bvanhoose14/Smart-Bike-Kit/README.md

# Project BITbike

### Group Members: **Spencer Durrant, Ben Van Hoose, Tristan Stotesbery**

Welcome to our senior project github repository. For information about it please see our [website.](https://bvanhoose14.github.io/Smart-Bike-Kit/)
