bvanhoose14/Smart-Bike-Kit/5780 Mini Project/5780 Project Proposal.pdf

5780 Project Proposal
Group Members: Spencer Durrant, Ben Van Hoose, Tristan Stotesbery

Our group’s project idea is to make an LED-Matrix “License Plate” That can be attached to bicycles or ebikes, that can be controlled by a phone via bluetooth to send messages such as turn signals, brake lights, or just general display messages. The LED Matrix will be attached to a microcontroller, which will have a bluetooth module that interfaces with a phone as well as handlebar mounted buttons that can send different images to the display.

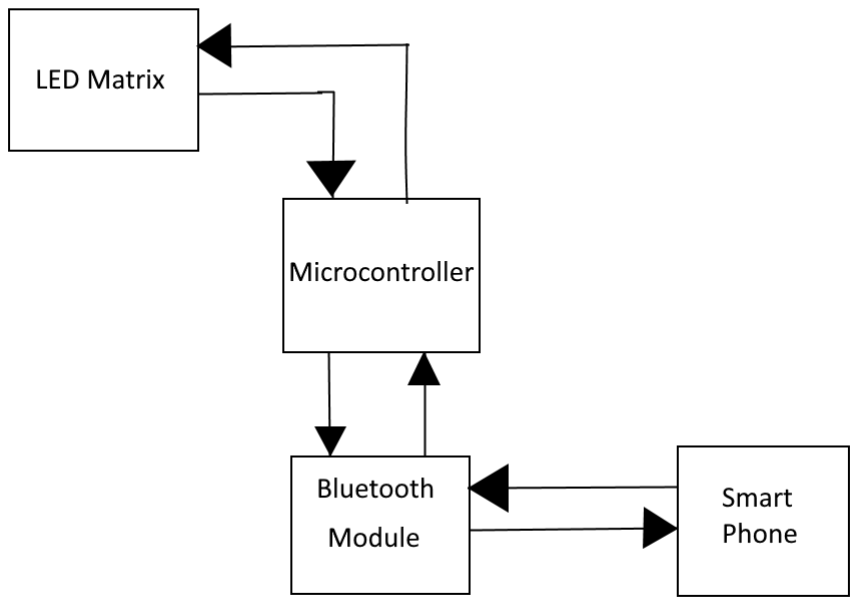
[picture p8: figure]

Milestone 1: Control microcontroller with phone via bluetooth module
Milestone 2: Connect and interface led matrix with microcontroller
Milestone 3: Power system with custom portable power supply
Milestone 4: Send images and signals to Microcontroller from phone to display on matrix
