bvanhoose14/Smart-Bike-Kit/Resources/BlockDiagram.pdf

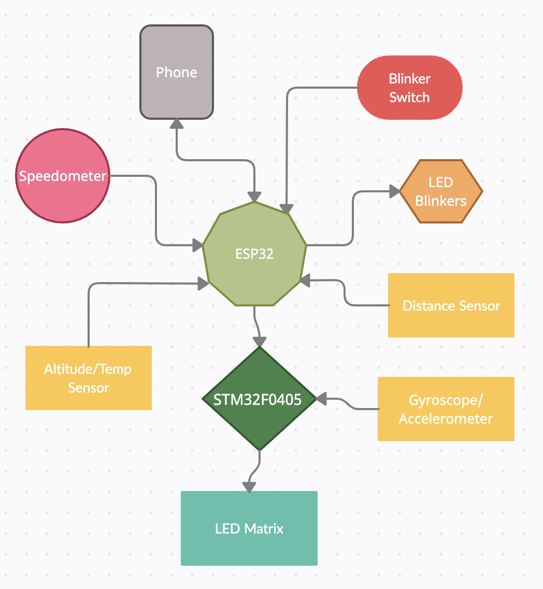
[picture p9: figure]
