bvanhoose14/Smart-Bike-Kit/images/ben.jpg

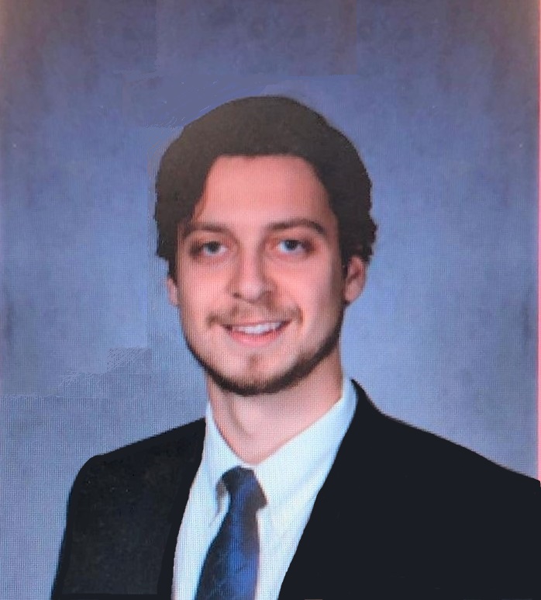
images/ben.jpg
