bvanhoose14/Smart-Bike-Kit/images/ebike.jpg

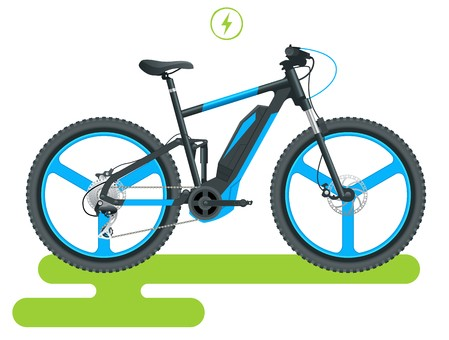
images/ebike.jpg
