bvanhoose14/Smart-Bike-Kit/images/exp32.jpg

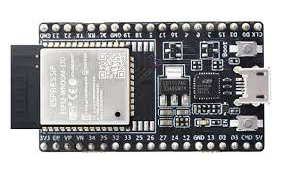
images/exp32.jpg
