bvanhoose14/Smart-Bike-Kit/images/mtbike2.jpg

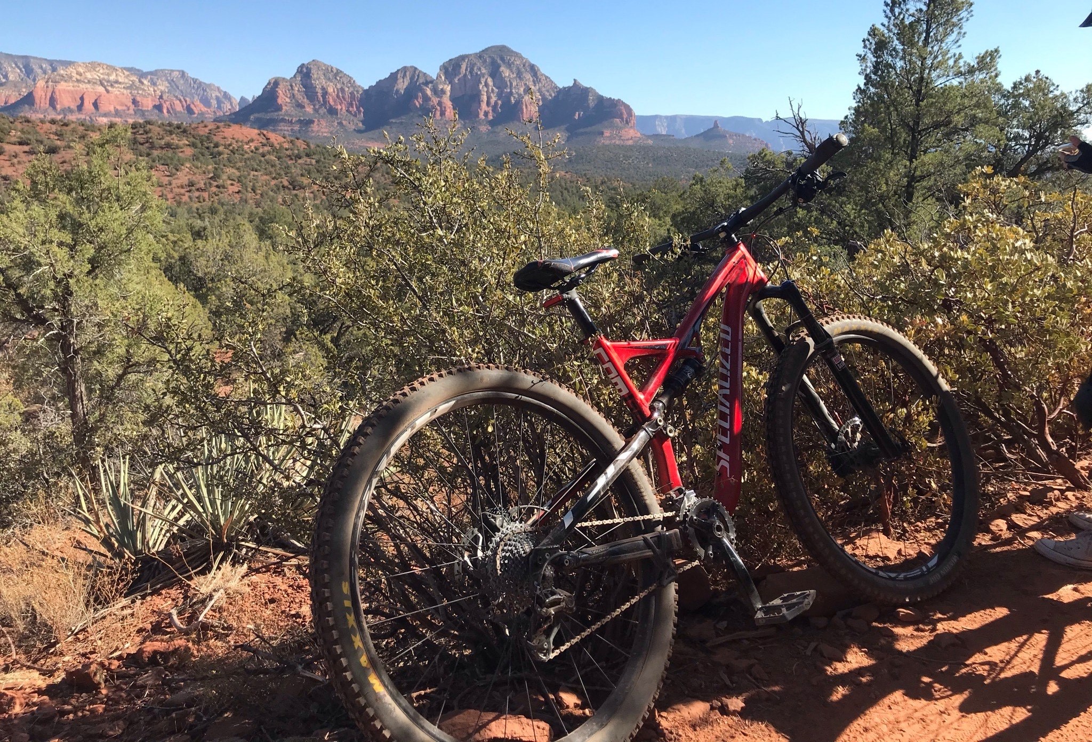
images/mtbike2.jpg
