bvanhoose14/Smart-Bike-Kit/images/rgbmatrix.jpg

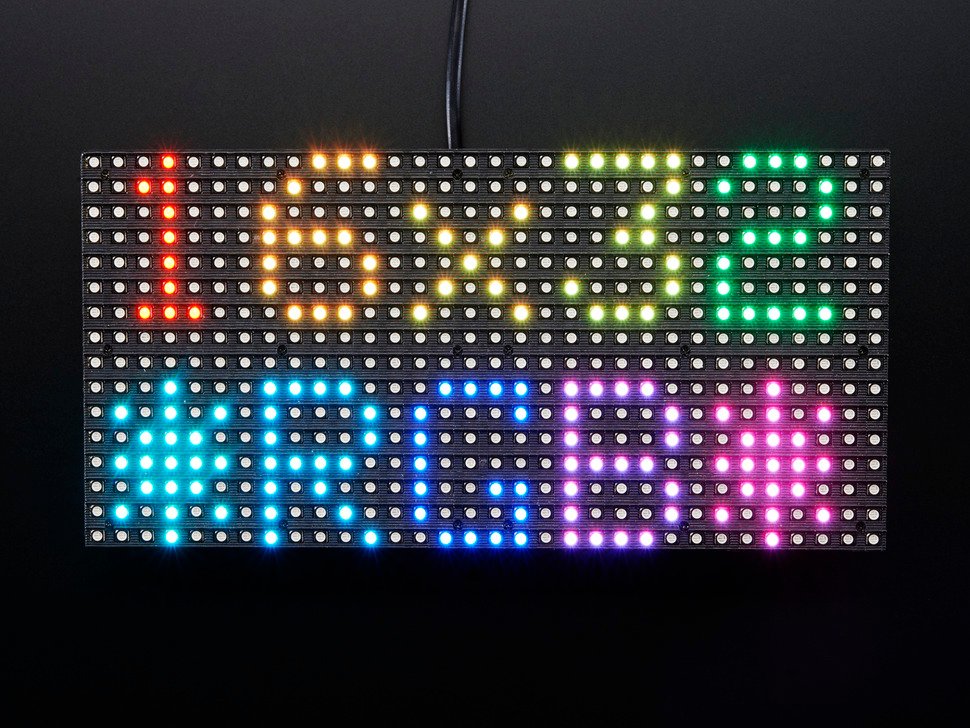
images/rgbmatrix.jpg
