bvanhoose14/Smart-Bike-Kit/images/slot-canyon-flash-flood2.jpg

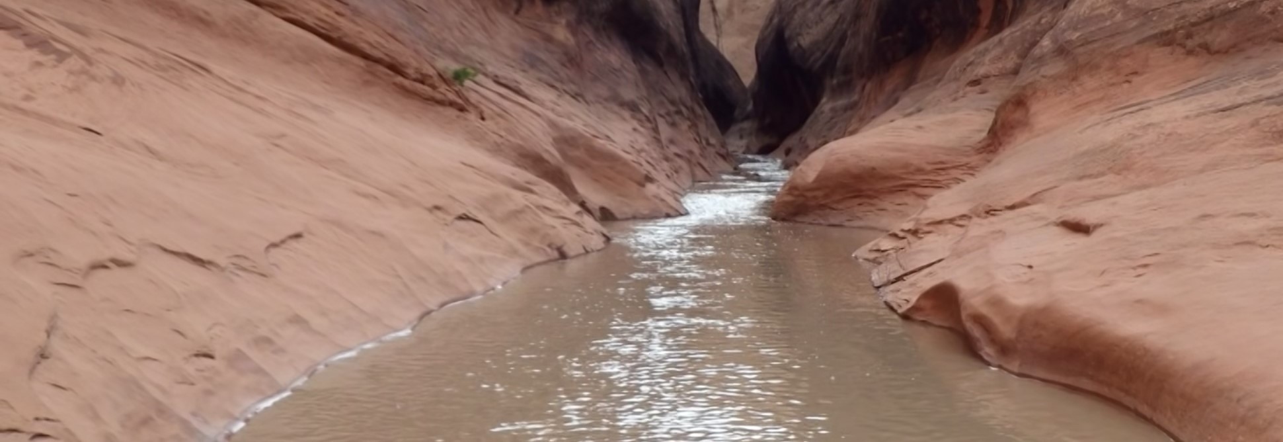
images/slot-canyon-flash-flood2.jpg
