bvanhoose14/Smart-Bike-Kit/images/slot-canyon-flash-flood.jpg

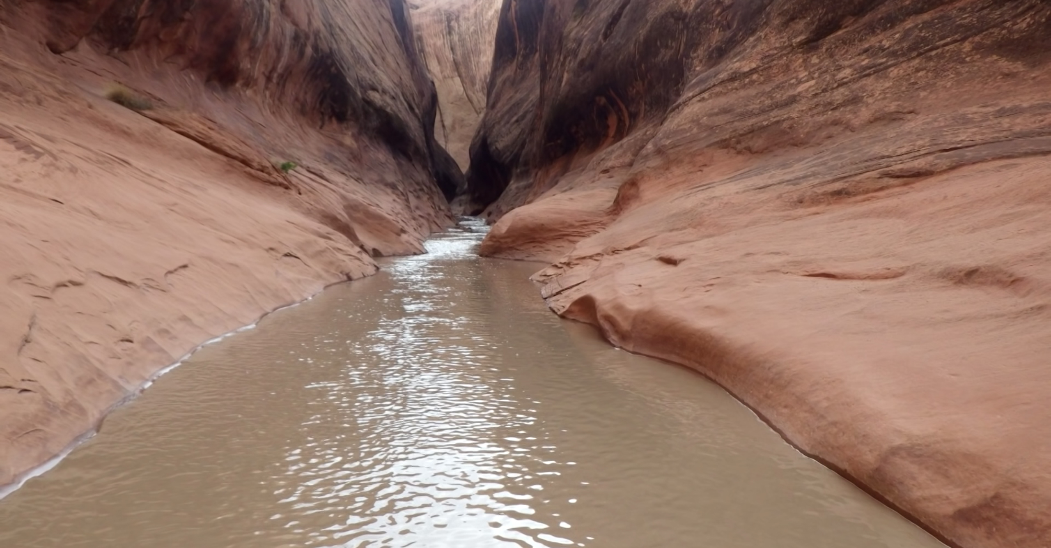
images/slot-canyon-flash-flood.jpg
