bvanhoose14/Smart-Bike-Kit/images/smbike_block_dgm.PNG

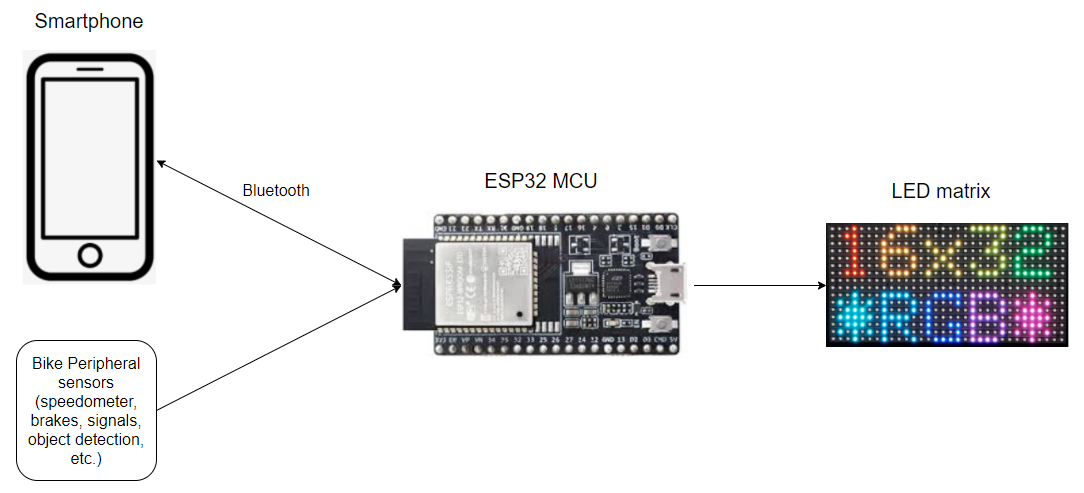
images/smbike_block_dgm.PNG
