bvanhoose14/Smart-Bike-Kit/images/spencer.jpg

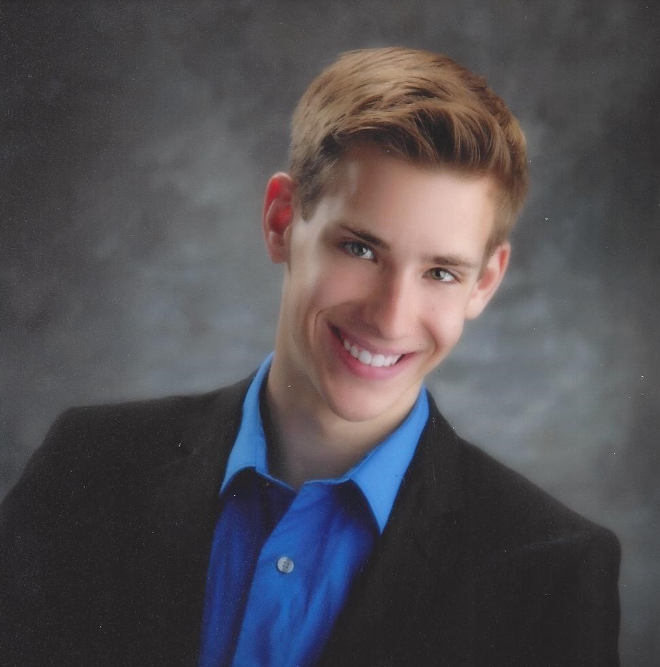
images/spencer.jpg
