bvanhoose14/Smart-Bike-Kit/images/tristan.JPG

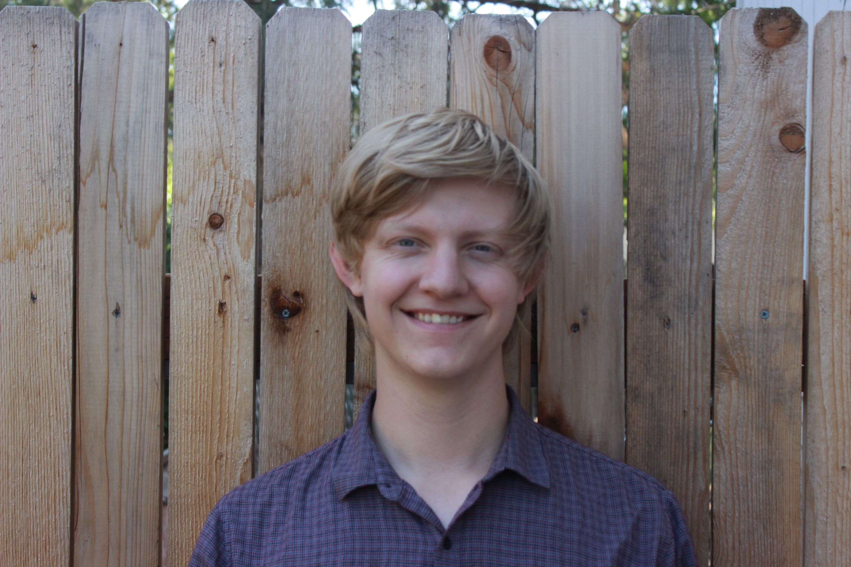
images/tristan.JPG
