bvanhoose14/Smart-Bike-Kit/images/water.jpg

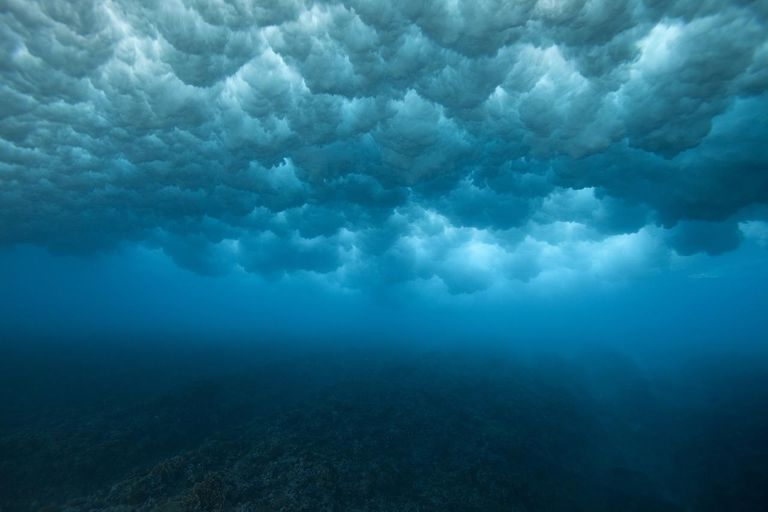
images/water.jpg
