bvanhoose14/Smart-Bike-Kit/3d-print/bitbike-print1.3mf

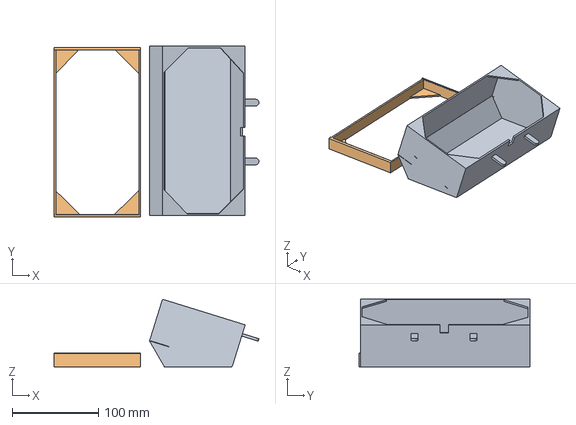
[picture p21: CAD file, 2021-11-15]
3d-print/bitbike-print1.3mf
237.1 x 198.2 x 78.2 mm
bitbike-print1 (3).stl
bitbike-print2.stl
