bvanhoose14/Smart-Bike-Kit/images/power-supply-diagram.pdf

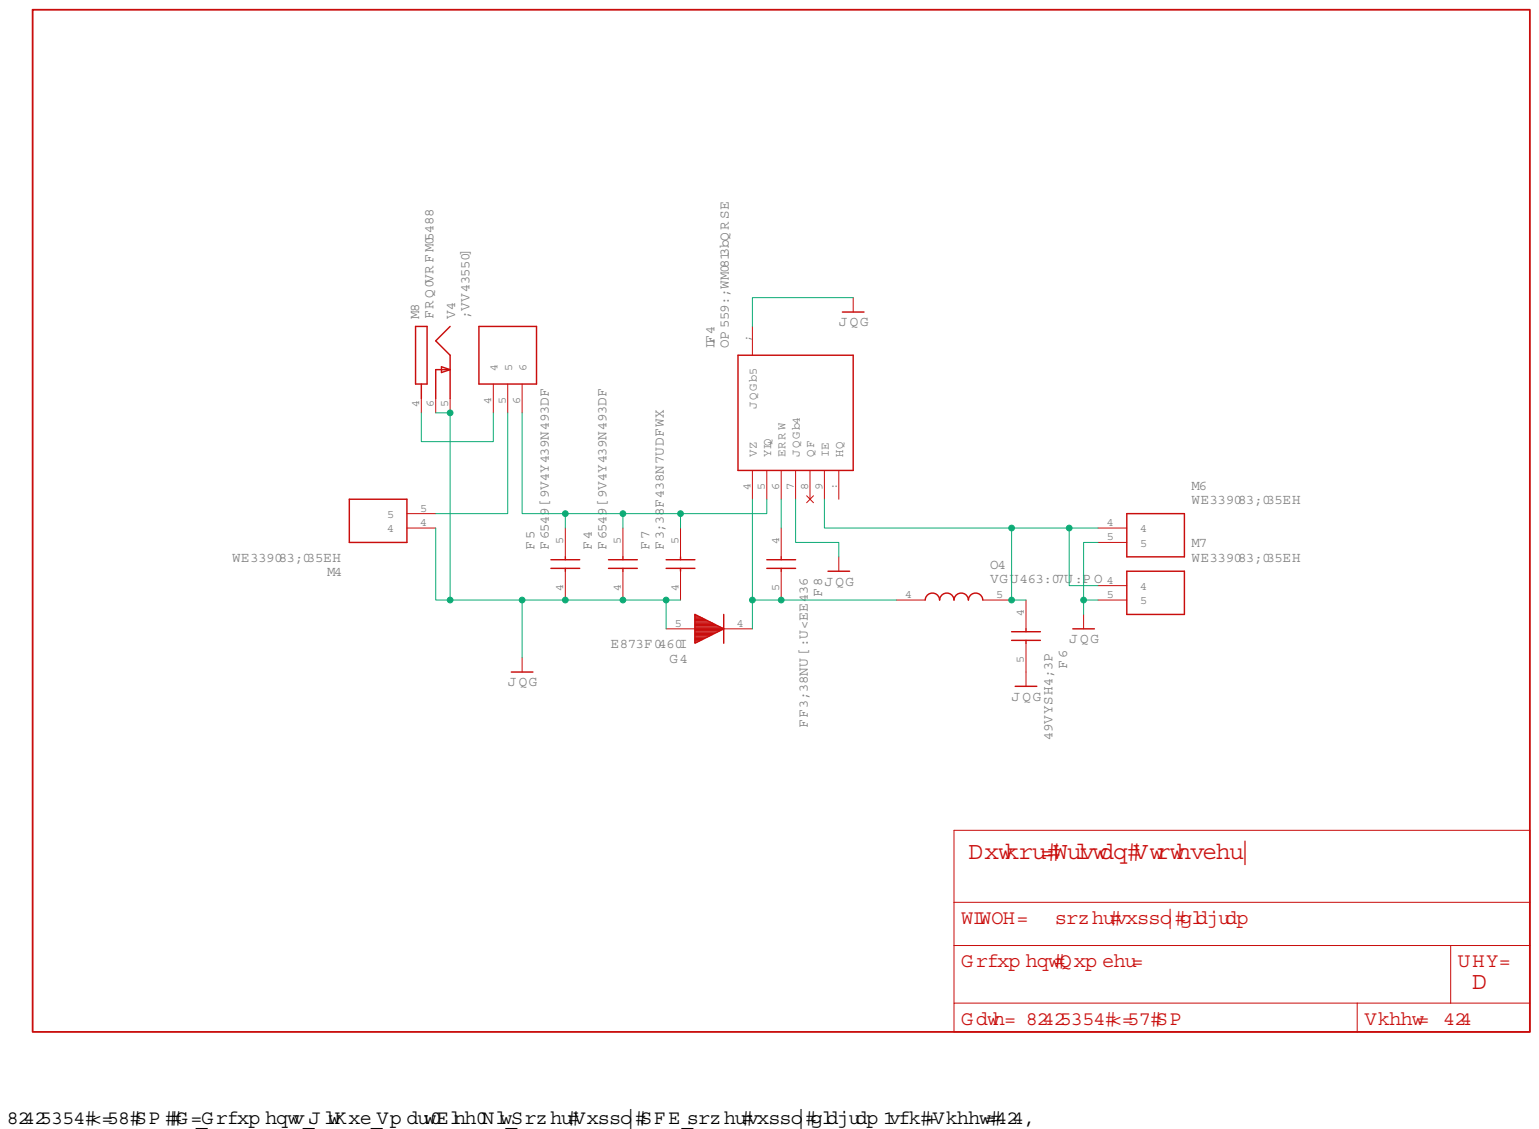
[picture p22: page 1]

pow er supply diagram

D ocum ent N um ber:

D ocum ents\GitH ub\Sm art-Bike-Kit\Pow er Supply PCB\pow er supply diagram .sch (Sheet: 1/1)
