bvanhoose14/Smart-Bike-Kit/5780 Mini Project/Power Supply PCB/power-supply-board.pdf

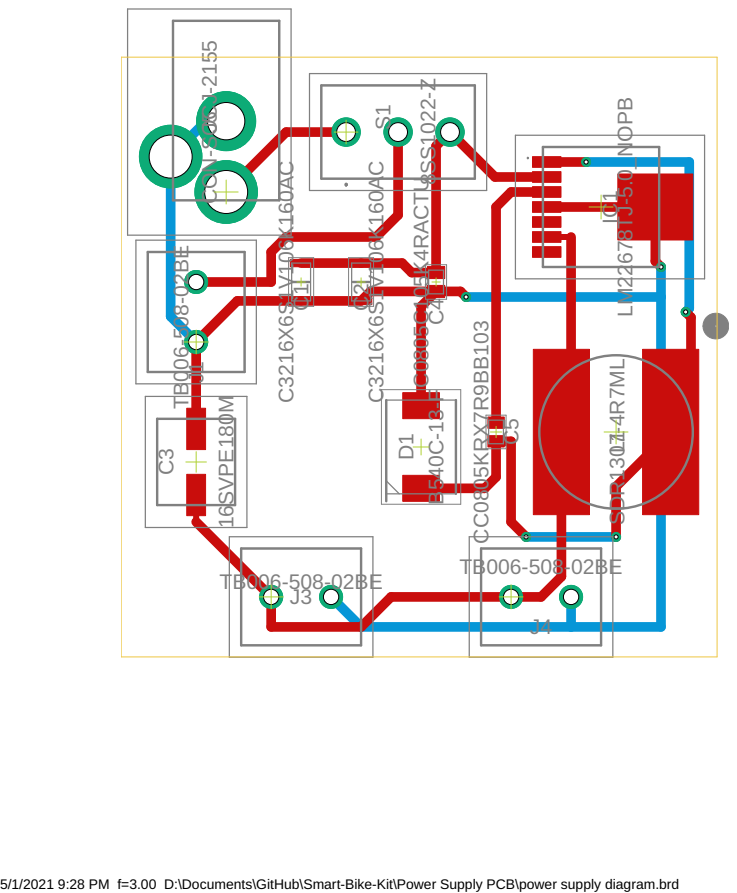
[picture p23: page 1]

5/1/2021 9:28 PM f=3.00 D:\Documents\GitHub\Smart-Bike-Kit\Power Supply PCB\power supply diagram.brd
