bvanhoose14/Smart-Bike-Kit/5780 Mini Project/Power Supply PCB/power-supply-diagram.pdf

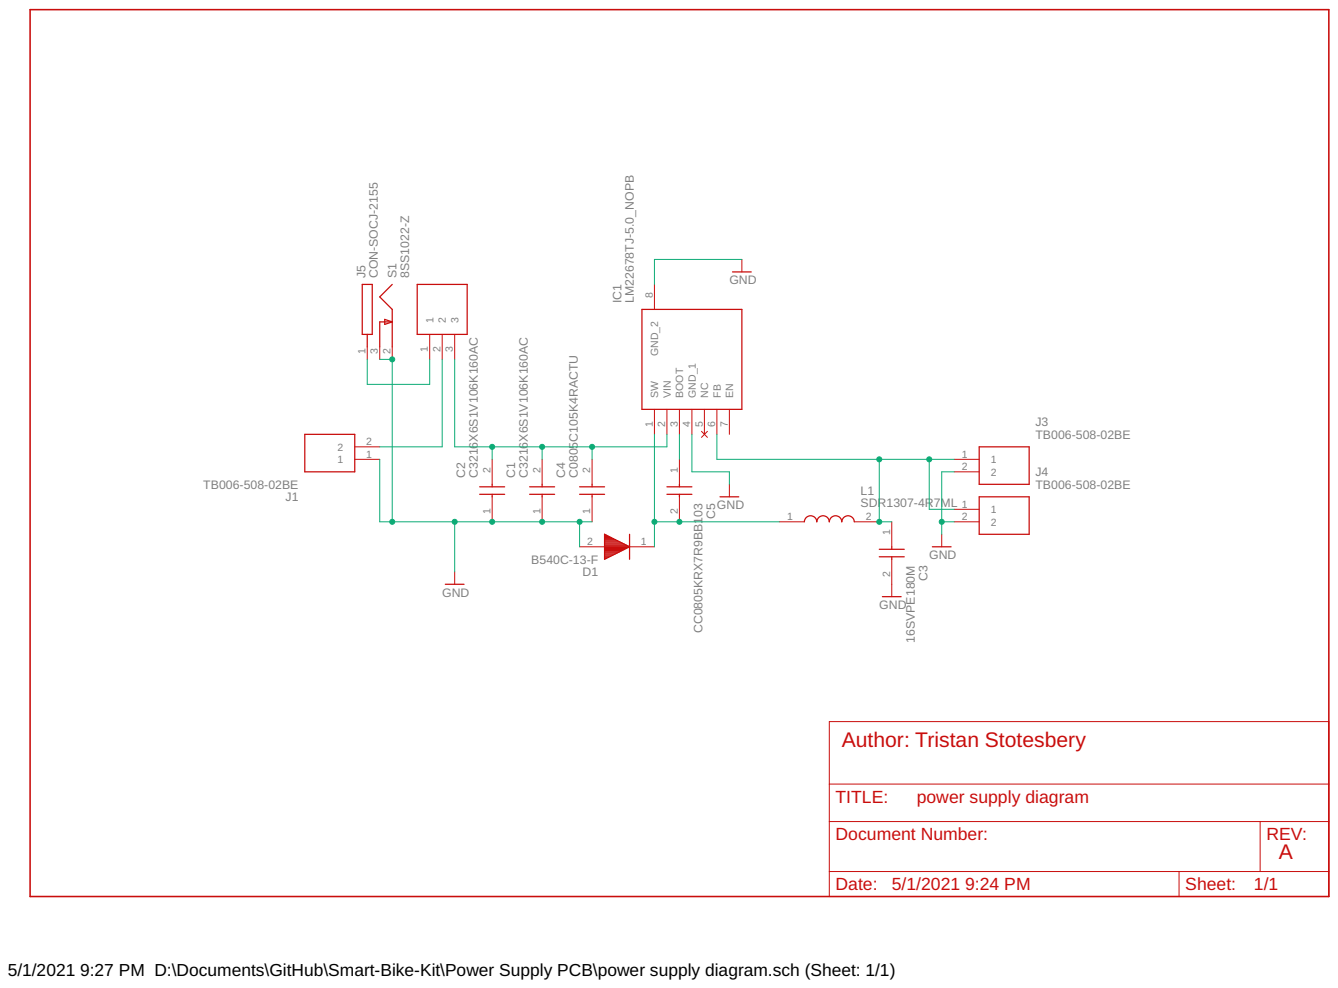
[picture p24: page 1]

Document Number: | REV: A

Date: 5/1/2021 9:24 PM | Sheet: 1/1

5/1/2021 9:27 PM D:\Documents\GitHub\Smart-Bike-Kit\Power Supply PCB\power supply diagram.sch (Sheet: 1/1)
