bvanhoose14/Smart-Bike-Kit/5780 Mini Project/Power Supply PCB/power supply diagram.brd

## EAGLE design 5780 Mini Project/Power Supply PCB/power supply diagram.brd (2021-05-02)

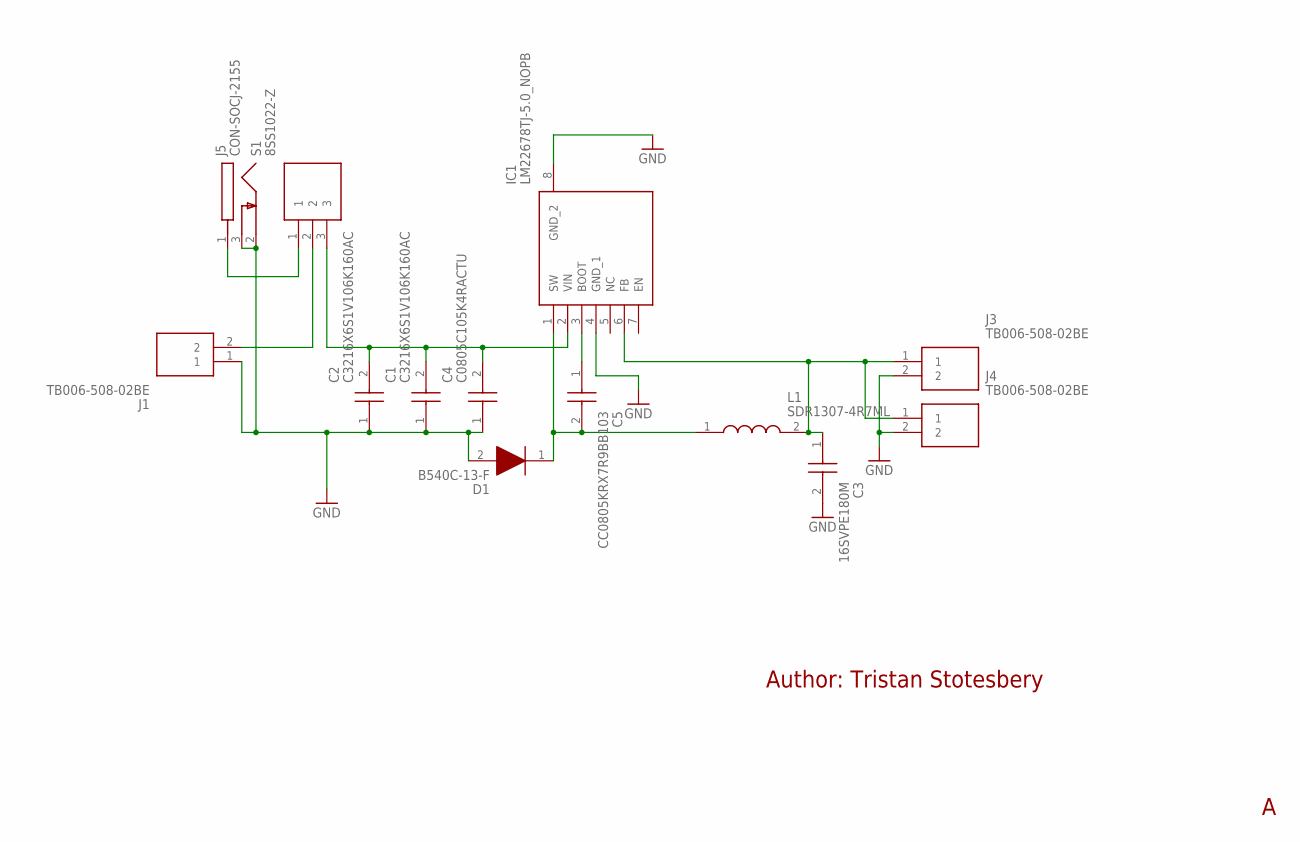
[picture p25: schematic power supply diagram.sch]

Parts:
C1, C2: C3216X6S1V106K160AC; CAPC3216X180N
C3: 16SVPE180M
C4: C0805C105K4RACTU; CAPC2012X100N
C5: CC0805KRX7R9BB103; CAPC2012X135N
D1: B540C-13-F; DIOM7959X250N
IC1: LM22678TJ-5.0_NOPB; LM22678TJ50NOPB
J1, J3, J4: TB006-508-02BE; TB00650802BE
J5: CON-SOCJ-2155; CONSOCJ2155
L1: SDR1307-4R7ML; SDR1307-220ML
S1: 8SS1022-Z; 8SS1022Z

Connections:
GND: C1.1, C2.1, C3.2, C4.1, D1.2 (A), IC1.4 (GND_1), IC1.8 (GND_2), J1.1, J3.2, J4.2, J5.2, J5.3
unnamed: C1.2, C2.2, C4.2, IC1.2 (VIN), S1.3
unnamed: J1.2, S1.2
unnamed: C5.1, IC1.3 (BOOT)
unnamed: C5.2, D1.1 (K), IC1.1 (SW), L1.1
unnamed: C3.1, IC1.6 (FB), J3.1, J4.1, L1.2
unnamed: J5.1, S1.1

Notes on the sheet:
Author: Tristan Stotesbery

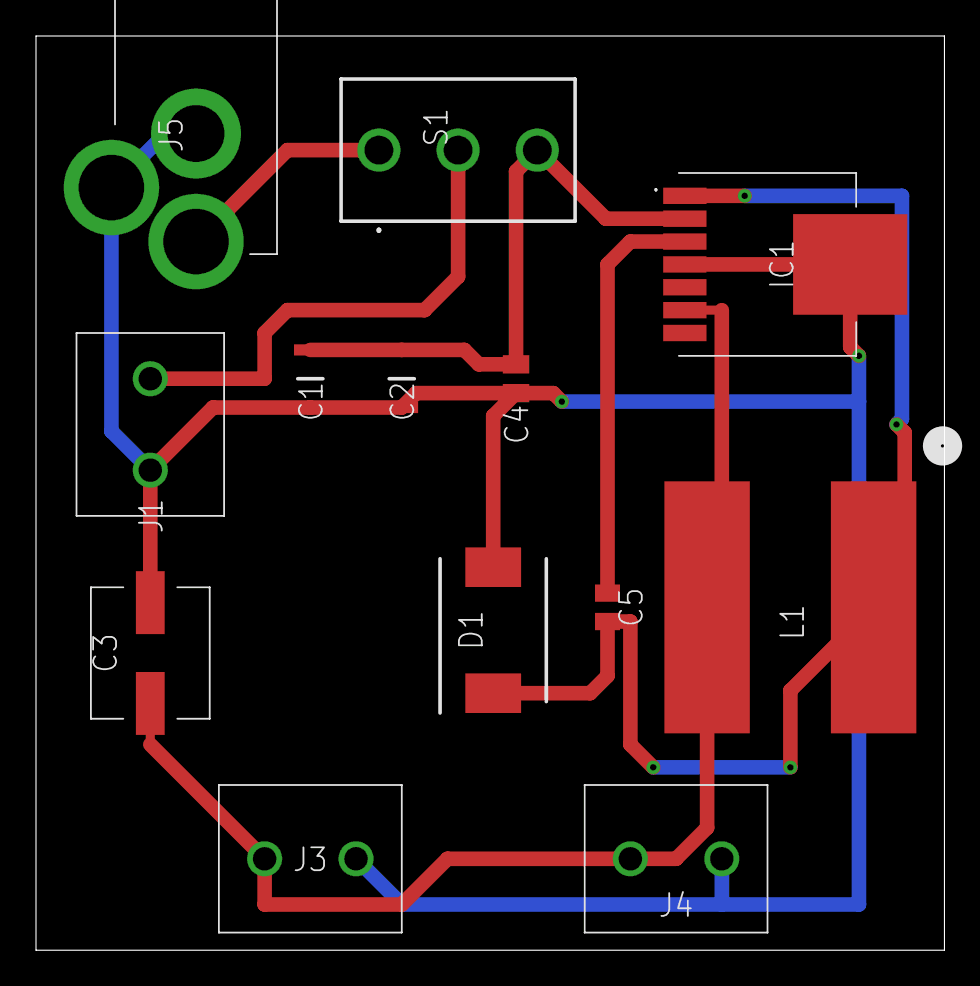
[picture p26: board power supply diagram.brd from above]

Board: 2 copper layers, 50.5 x 50.8 mm, 13 parts (0 on the bottom side), 7 nets.
