bvanhoose14/Smart-Bike-Kit/RGB-LED-matrix/inc/main.h

#define sCLK_Pin GPIO_PIN_1
#define sCLK_GPIO_Port GPIOC
#define B2_Pin GPIO_PIN_2
#define B2_GPIO_Port GPIOC
#define R2_Pin GPIO_PIN_3
#define R2_GPIO_Port GPIOC
#define LEFT_A0_Pin GPIO_PIN_4
#define LEFT_A0_GPIO_Port GPIOA
#define RIGHT_A1_Pin GPIO_PIN_5
#define RIGHT_A1_GPIO_Port GPIOA
#define BRAKE_A2_Pin GPIO_PIN_6
#define BRAKE_A2_GPIO_Port GPIOA
#define C_Pin GPIO_PIN_7
#define C_GPIO_Port GPIOA
#define B_Pin GPIO_PIN_4
#define B_GPIO_Port GPIOC
#define A_Pin GPIO_PIN_5
#define A_GPIO_Port GPIOC
#define OE_Pin GPIO_PIN_10
#define OE_GPIO_Port GPIOB
#define LAT_Pin GPIO_PIN_11
#define LAT_GPIO_Port GPIOB
#define CLEAR_Pin GPIO_PIN_13
#define CLEAR_GPIO_Port GPIOB
#define R1_Pin GPIO_PIN_6
#define R1_GPIO_Port GPIOC
#define G1_Pin GPIO_PIN_7
#define G1_GPIO_Port GPIOC
#define B1_Pin GPIO_PIN_8
#define B1_GPIO_Port GPIOB
#define G2_Pin GPIO_PIN_9
#define G2_GPIO_Port GPIOB
