bvanhoose14/Smart-Bike-Kit/RGB-LED-matrix/inc/graphics.h

/*
 * graphics.h
 *
 *  Created on: Sep 28, 2021
 *      Author: Spencer Durrant
 */

#ifndef INC_GRAPHICS_H_
#define INC_GRAPHICS_H_

//#include "stm32f4xx_hal.h"
//
//typedef struct {
//
//} led_cfg;

const unsigned int BLANK[16] = {
	0x00000000, 0x00000000, 0x00000000,
	0x00000000, 0x00000000, 0x00000000,
	0x00000000, 0x00000000, 0x00000000,
	0x00000000, 0x00000000, 0x00000000,
	0x00000000, 0x00000000, 0x00000000,
	0x00000000
};

const unsigned int R_BOX[16] = {
	0xffffffff, 0x80000001, 0x80000001,
	0x80000001, 0x80000001, 0x80000001,
	0x80000001, 0x80000001, 0x80000001,
	0x80000001, 0x80000001, 0x80000001,
	0x80000001, 0x80000001, 0x80000001,
	0xffffffff
};
const unsigned int G_BOX[16] = {
	0xffffffff, 0x80000001, 0x80000001,
	0x80000001, 0x80000001, 0x80000001,
	0x80000001, 0x80000001, 0x80000001,
	0x80000001, 0x80000001, 0x80000001,
	0x80000001, 0x80000001, 0x80000001,
	0xffffffff
};
const unsigned int B_BOX[16] = {
	0xffffffff, 0x80000001, 0x80000001,
	0x80000001, 0x80000001, 0x80000001,
	0x80000001, 0x80000001, 0x80000001,
	0x80000001, 0x80000001, 0x80000001,
	0x80000001, 0x80000001, 0x80000001,
	0xffffffff
};

const unsigned int R_CIRCLE[16] = {
	0x0007e000, 0x00181800, 0x00200400,
	0x00400200, 0x00400200, 0x00800100,
	0x00800100, 0x00800100, 0x00800100,
	0x00800100, 0x00800100, 0x00400200,
	0x00400200, 0x00200400, 0x00181800,
	0x0007e000
};
const unsigned int G_CIRCLE[16] = {
	0x0007e000, 0x00181800, 0x00200400,
	0x00400200, 0x00400200, 0x00800100,
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
	0xffffffff
};
const unsigned int R_L_ARR2_BOX[16] = {
	0xffffffff, 0x80004081, 0x800060c1,
	0x80003061, 0x80001831, 0x80000c19,
	0x8000060d, 0x80000307, 0x80000307,
	0x8000060d, 0x80000c19, 0x80001831,
	0x80003061, 0x800060c1, 0x80004081,
	0xffffffff
};

#endif /* INC_GRAPHICS_H_ */
