bvanhoose14/Smart-Bike-Kit/gyro/src/hal_log.c

/*
 * hal_log.c
 *
 *  Created on: May 18, 2021
 *      Author: Spencer
 */

#include "hal_log.h"

void init_handle(UART_HandleTypeDef *huart_)  { huart = huart_; }

/** Custom printf function in order to use HAL_UART_Transmit()
 * @param *fmt String to print
 * @param argp Parameters list
 */
void HAL_printf_valist(const char *fmt, va_list argp) {
  char string[PRINT_BUFFER_SIZE];

  	  //NOTE: THIS IS HARDCODED RIGHT NOW FOR UART3 CREATED IN main.c
  if (vsprintf(string, fmt, argp) > 0) {
    HAL_UART_Transmit(huart, (uint8_t*)string, strlen(string), 100); // send message via UART
  } else {
	HAL_UART_Transmit(huart, (uint8_t*)"E - Print\n", 14, 100);
  }
}

/** Custom printf function, only translate to va_list arg HAL_UART.
 * @param *fmt String to print
 * @param ... Data
 */
void HAL_printf(const char *fmt, ...) {
  va_list argp;

  va_start(argp, fmt);
  HAL_printf_valist(fmt, argp);
  va_end(argp);
}

/** Generic LOG procedure
 * @param Log level
 * @param *fmt String to print
 * @param argp Parameters list
 */
void logg(uint8_t level, const char *fmt, va_list argp) {
	HAL_printf("%c - ", level);
	HAL_printf_valist(fmt, argp);
}

/** LOG procedure - Info
 * @param *fmt String to print
 * @param ... Parameters list
 */
void logI(const char* fmt, ...) {
  va_list argp;

	va_start(argp, fmt);
	logg('I', fmt, argp);
	va_end(argp);
}

/** LOG procedure - Error
 * @param *fmt String to print
 * @param .. Parameters list
 */
void logE(const char* fmt, ...) {
  va_list argp;

  va_start(argp, fmt);
  logg('E', fmt, argp);
  va_end(argp);
}

void reverse(char* str, int len)
{
    int i = 0, j = len - 1, temp;
    while (i < j) {
        temp = str[i];
        str[i] = str[j];
        str[j] = temp;
        i++;
        j--;
    }
}

int intToStr(int x, char str[], int d)
{
    int i = 0;
    while (x) {
        str[i++] = (x % 10) + '0';
        x = x / 10;
    }

    // If number of digits required is more, then
    // add 0s at the beginning
    while (i < d)
        str[i++] = '0';

    reverse(str, i);
    str[i] = '\0';
    return i;
}

void ftoa(float n, char* res, int afterpoint) {
	int ipart = (int)n;

	// Extract floating part
	float fpart = n - (float)ipart;

	// convert integer part to string
	int i = intToStr(ipart, res, 0);

	// check for display option after point
	if (afterpoint != 0) {
		res[i] = '.'; // add dot

		// Get the value of fraction part upto given no.
		// of points after dot. The third parameter
		// is needed to handle cases like 233.007
		fpart = fpart * pow(10, afterpoint);

		intToStr((int)fpart, res + i + 1, afterpoint);
	}
}
