bvanhoose14/Smart-Bike-Kit/(commit log)

2021-04-29 Matrix with STM32 first working version
2021-04-30 Power Supply Schematic and PCB Layout
    [power supply diagram.brd, power supply diagram.sch]
2021-05-02 power supply pdfs
2021-05-02 Remove LED SCROLLING
2021-05-02 added LED_off function
2021-05-03 Organized Files for 5780 Project
    Seperated code into 2 versions: V1 is the code that has self-cancelling turn signals working
    V2 is the code that is running the LED Matrix off of the STM32 instead of the ESP32
    [power supply diagram.brd, power supply diagram.sch]
2021-08-09 Updated Maps
    Maps now track user location
2021-10-20 gyro logger
2021-10-20 Added my sensor files
2021-10-20 pin update
2021-10-21 fixed the distance sensor bug
    [Sensors-Ben.ino]
2021-11-11 first 3d print file
    [bitbike-print1.3mf]
